ctsaitsao/DC_2019/(commit log)

2019-05-09 Uploaded all Arduino files.
2019-05-09 Updated code so that servo works.
2019-05-10 Drive works, servo works, distance sensor works, vive works.
2019-05-10 Light sensor works.
2019-05-11 Incremental forward velocity works.
2019-05-11 I added the Vive position calibration
2019-05-11 I added the MATLAB coordinate calibration code
2021-01-12 Added sensors pic.
2021-01-12 Added touch sensor pic.
